westonb/plasma-pitch/pcb/schematic/plasma_modulator.pdf

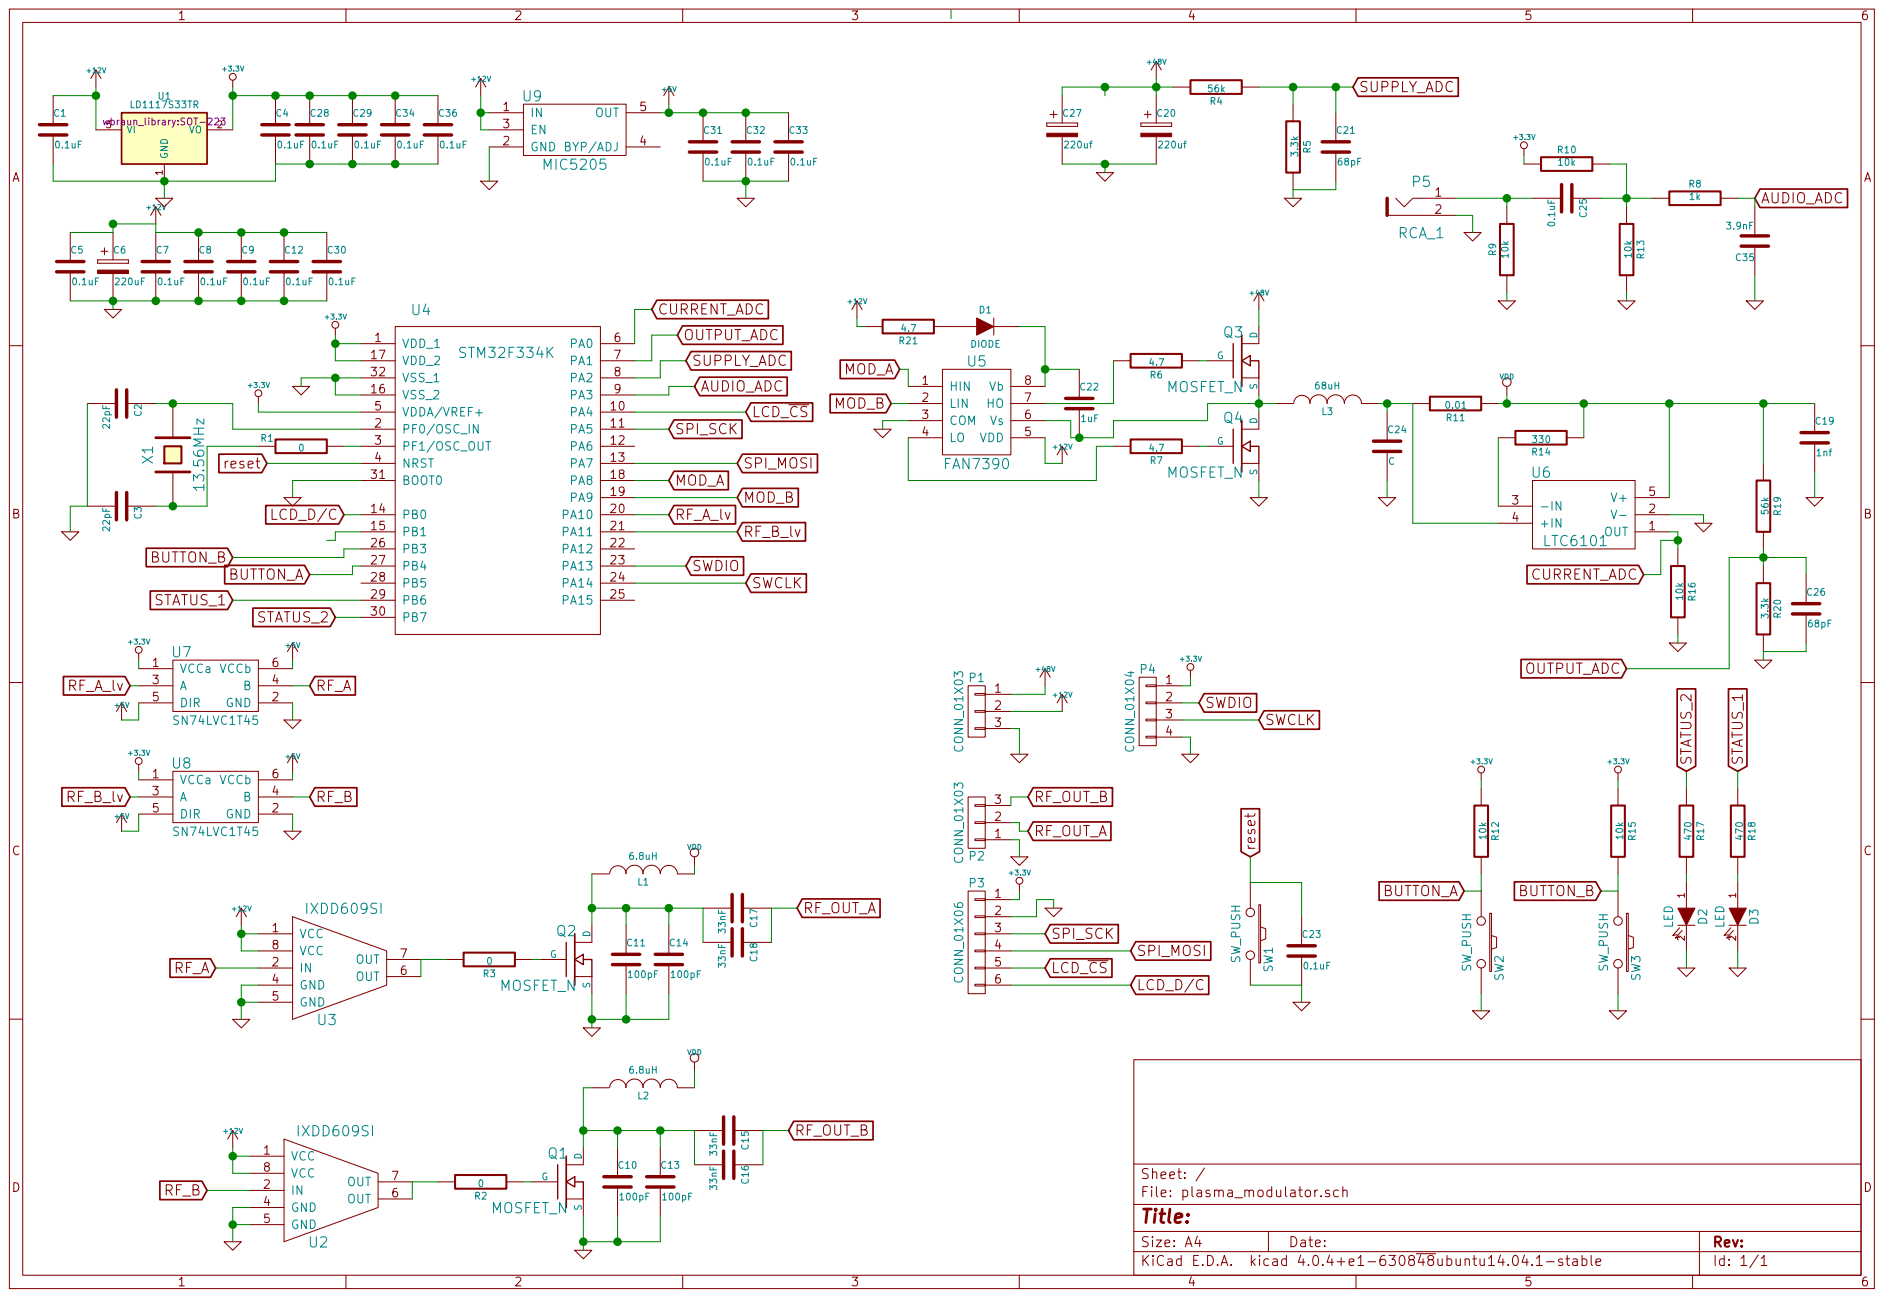
[picture p1: page 1]
