westonb/plasma-pitch/pcb/pcb_layout/plasma_modulator-B.Cu.pdf

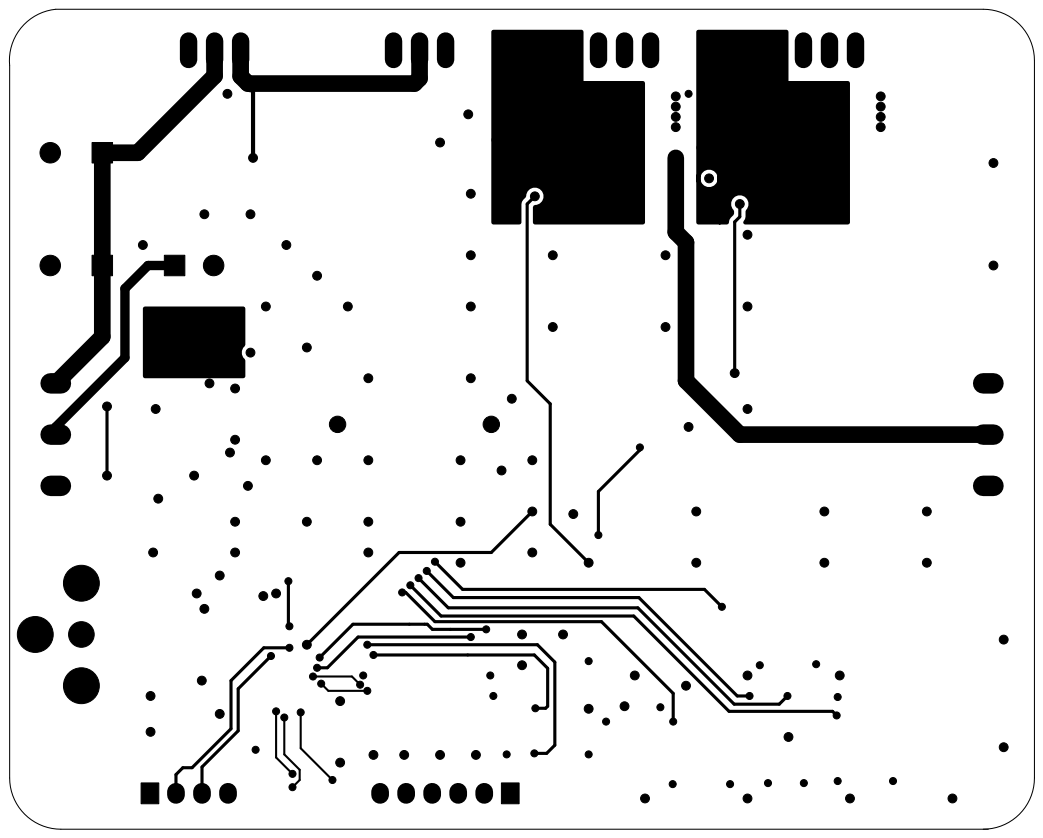
[picture p2: page 1]
