westonb/plasma-pitch/pcb/pcb_layout/plasma_modulator-B.Mask.pdf

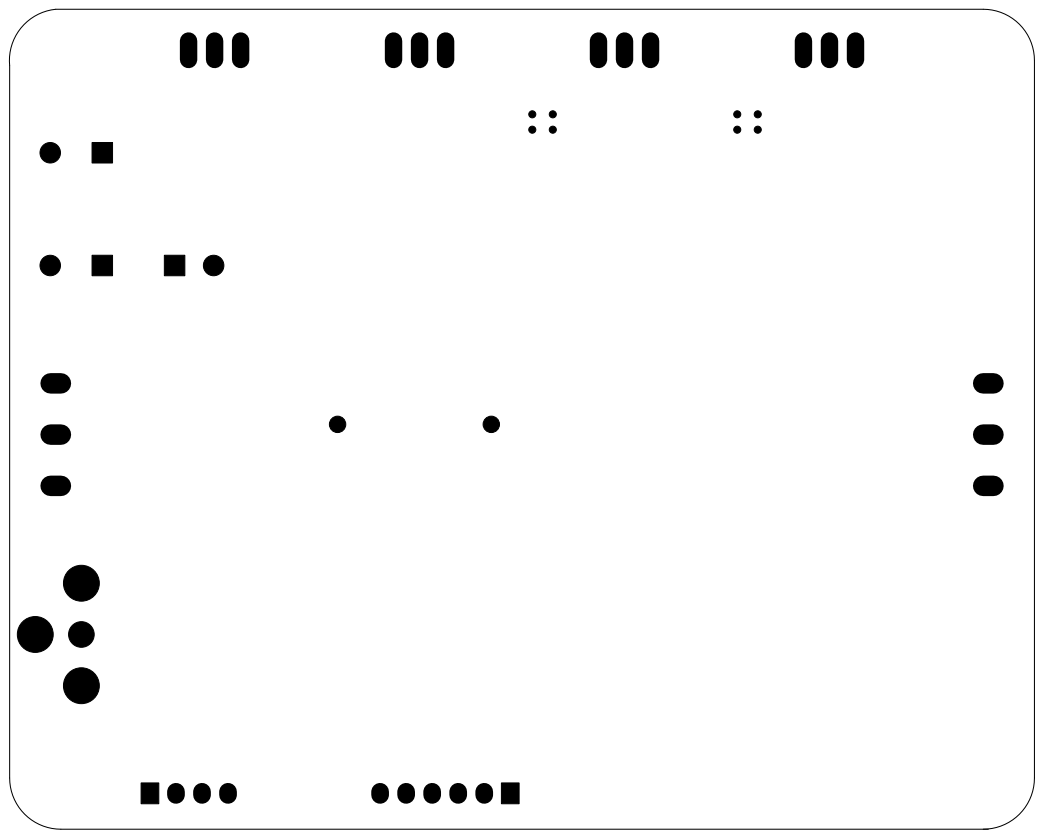
[picture p3: page 1]
