westonb/plasma-pitch/pcb/pcb_layout/plasma_modulator-B.SilkS.pdf

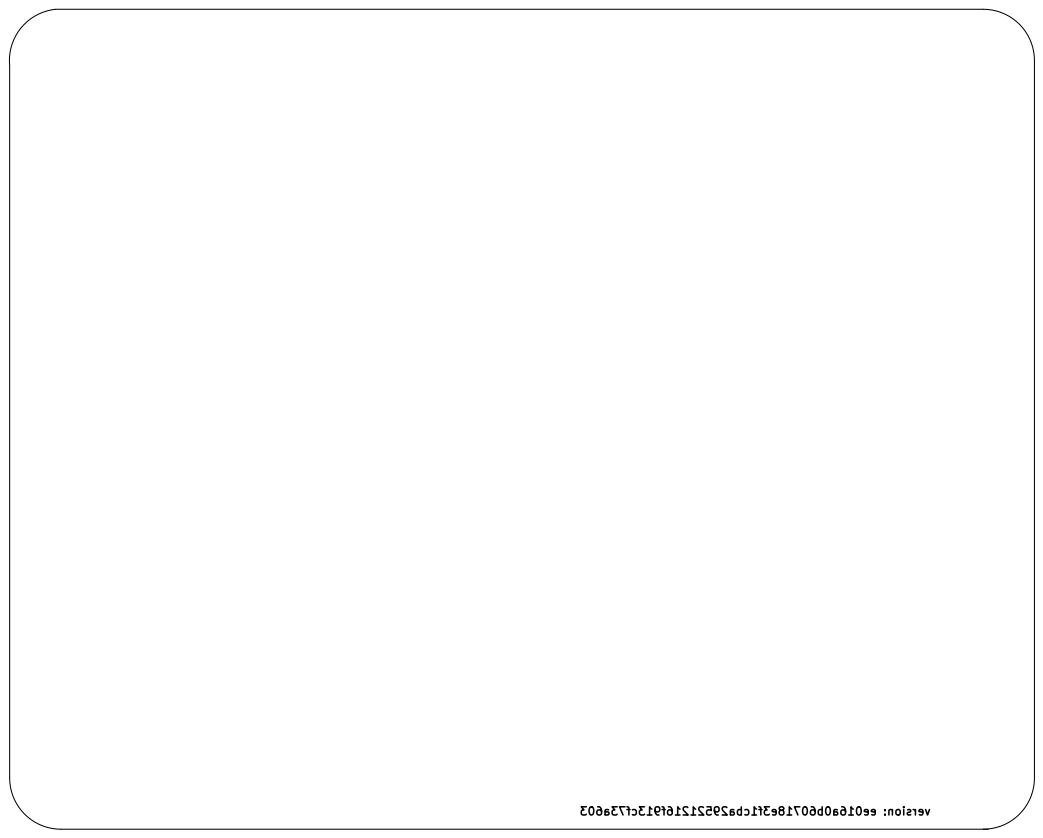
[picture p4: page 1]
