westonb/plasma-pitch/pcb/pcb_layout/plasma_modulator-Edge.Cuts.pdf

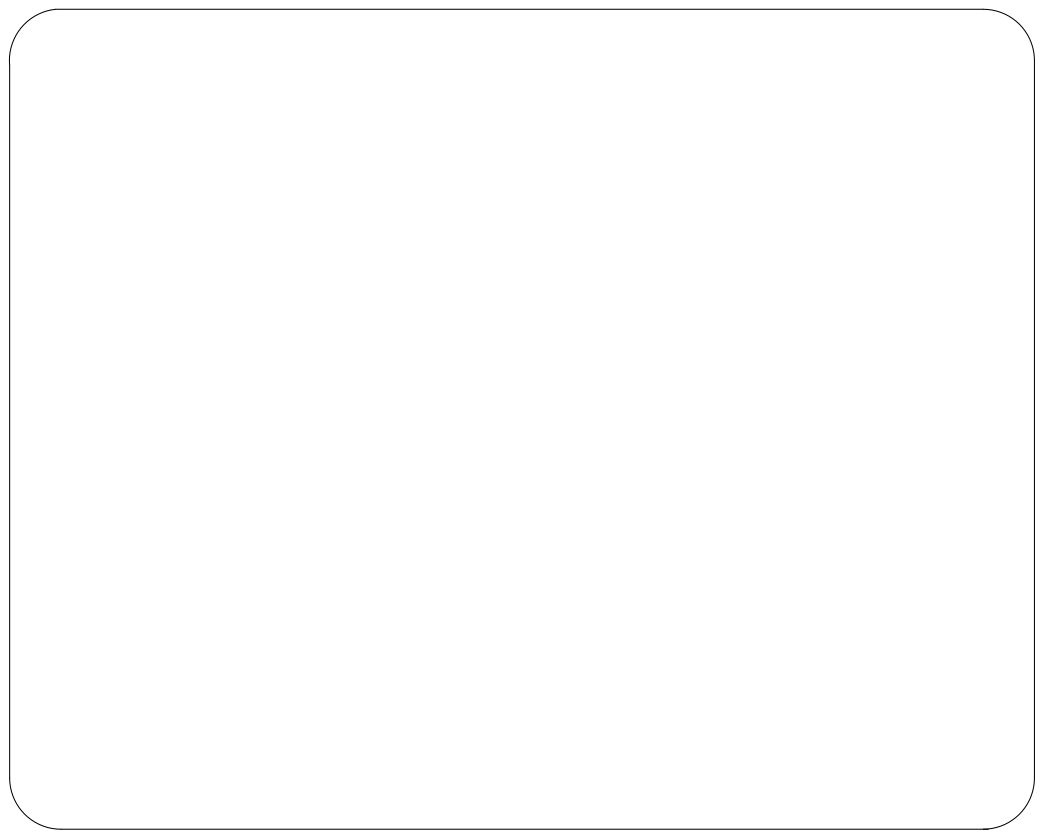
[picture p5: page 1]
