westonb/plasma-pitch/pcb/pcb_layout/plasma_modulator-F.Cu.pdf

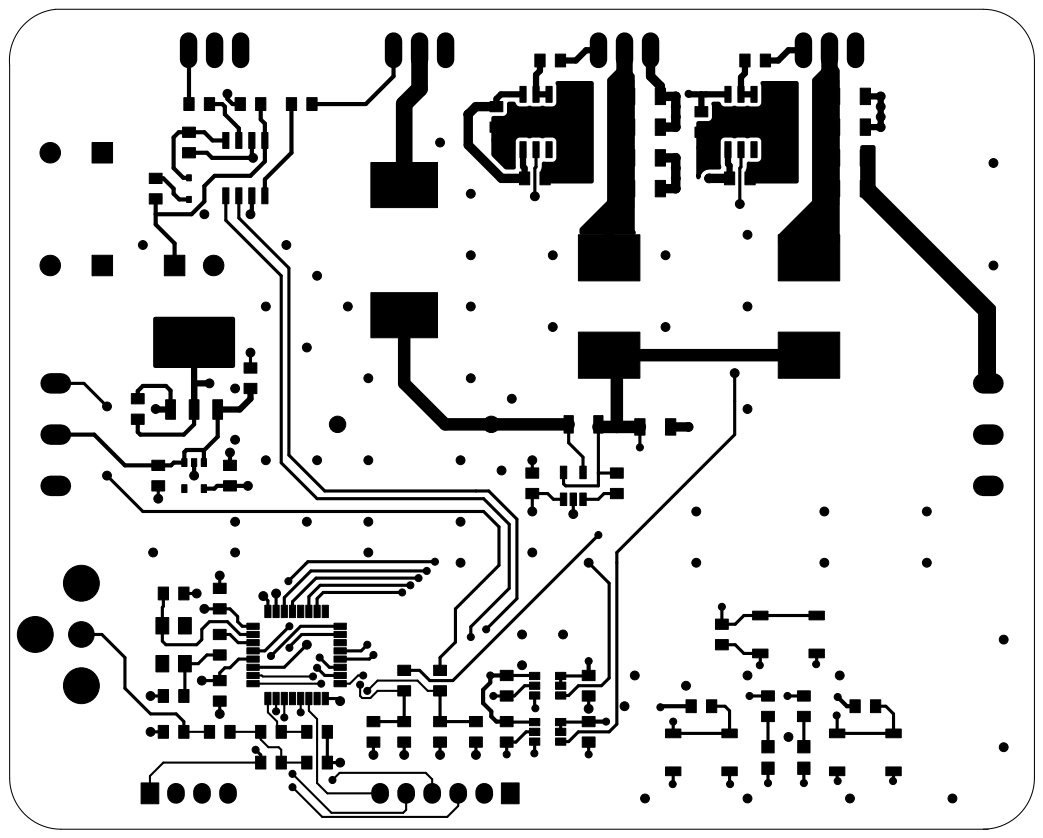
[picture p6: page 1]
