westonb/plasma-pitch/pcb/pcb_layout/plasma_modulator-F.Mask.pdf

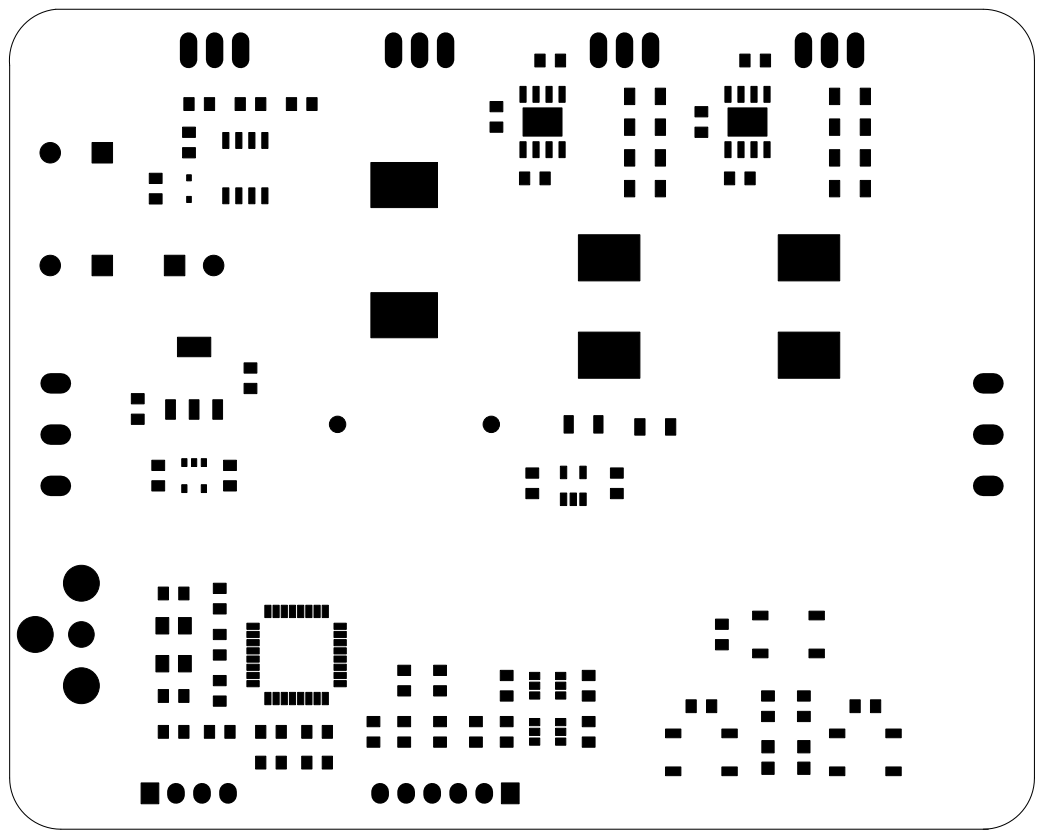
[picture p7: page 1]
