westonb/plasma-pitch/pcb/pcb_layout/plasma_modulator-F.SilkS.pdf

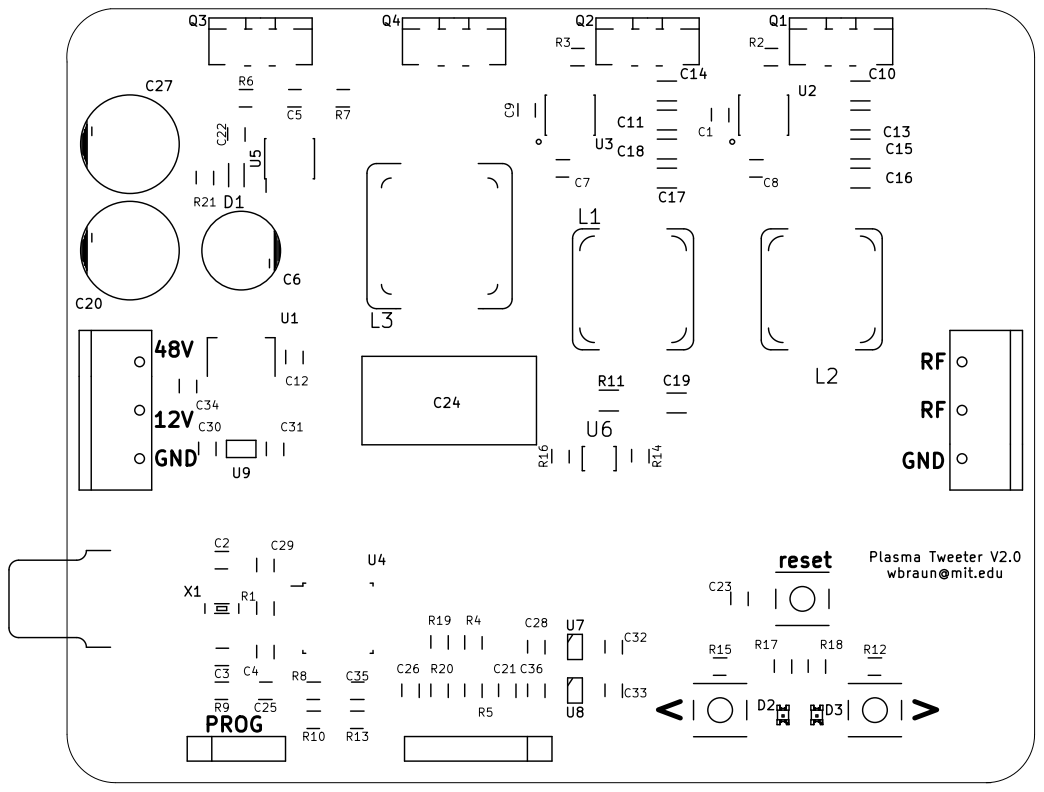
[picture p8: page 1]

Plasma Tweeter V2.0 wbraun@mit.edu PROG
