westonb/plasma-pitch/pcb/pcb_layout/plasma_modulator-In1.Cu.pdf

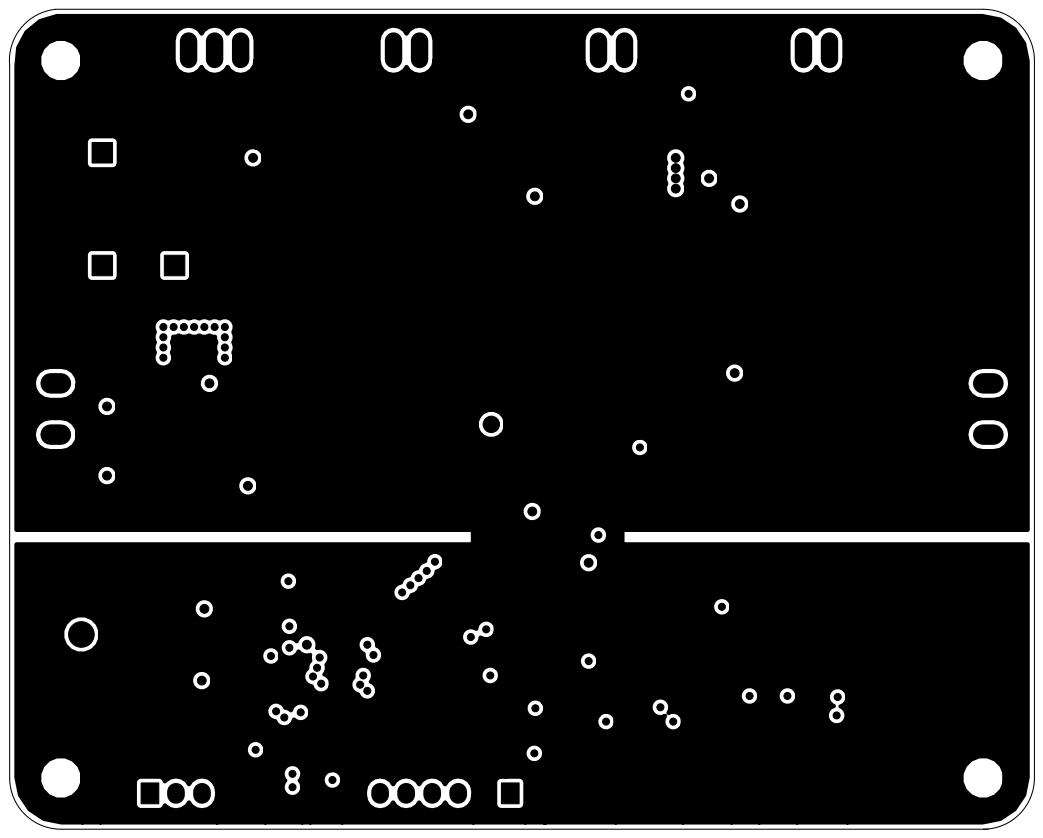
[picture p9: page 1]
