westonb/plasma-pitch/pcb/pcb_layout/plasma_modulator-In2.Cu.pdf

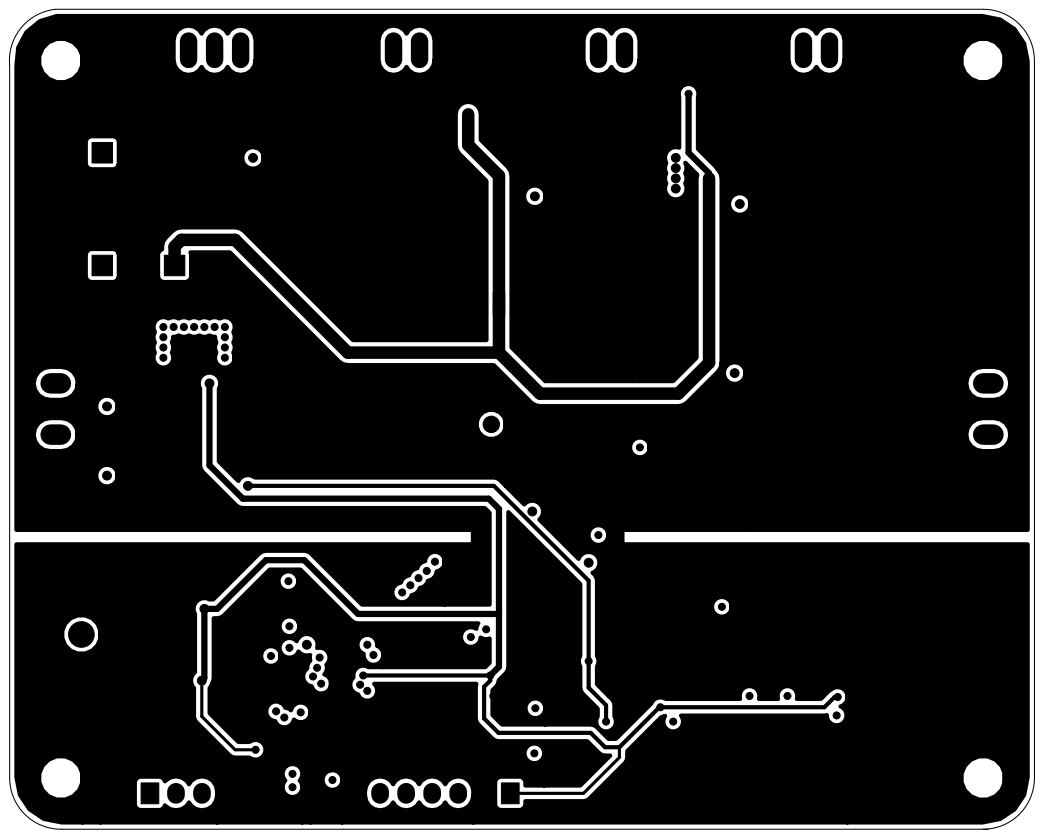
[picture p10: page 1]
