westonb/plasma-pitch/(commit log)

2015-03-09 first commit. Added PCB files from previous project
    [plasma_modulator.kicad_pcb, plasma_modulator.sch]
2015-03-10 ADC and system timer work
2015-05-05 calculated correct control loop constants, modulator is now stable
    [main.c]
2016-10-28 plotted schematic and PCB layouts
    [plasma_modulator.sch]
2016-11-27 added schematic
